drujensen/eater-one/(commit log)

2021-07-25 fix: even better
    [build.cfg]
2021-07-31 feat: add example apps
    [build.cfg]
2021-07-31 feat: add tiny basic
    [build.cfg]
2021-08-08 feat: expand memory to 31k
    [build.cfg]
2021-08-14 initial version
    [applesoft.cfg, build.cfg, cbmbasic1.cfg, cbmbasic2.cfg, kb9.cfg, kbdbasic.cfg, microtan.cfg, none.cfg]
2022-01-19 fix: assembly examples
2022-02-25 feat: add image of tiny basic
    [build.cfg]
